ci-rt/testbox-shield/(notices)

Notices in the files:
serial.sch:
Lizenz zu sehen, besuchen Sie http://creativecommons.org/licenses/by-sa/4.0/.
power.sch:
of this license, visit http://creativecommons.org/licenses/by-nc-sa/4.0/.
This work is licensed under the Creative Commons
